0kouhj/STM32_ASC_ThirdRound_Car/设计总纲.docx

一、物料准备

4个TT130电机独立控制（2块TB6612 驱动）

- 对左右两侧测速（光电编码器×2）
- 红外反射模块×4
- 按键×4
- OLED屏幕×1（I2C）
- 主控：STM32F103C8T6（即“蓝色小板”）

二、引脚表

功能 | 引脚 | 备注
PWM M1 | PA0 (TIM2_CH1) | 左前电机
PWM M2 | PA1 (TIM2_CH2) | 右前电机
PWM M3 | PA2 (TIM2_CH3) | 左后电机
PWM M4 | PA3 (TIM2_CH4) | 右后电机
DIR1A, DIR1B | PB12, PB13 | TB6612 #1 左电机方向
DIR2A, DIR2B | PB14, PB15 | TB6612 #1 右电机方向
DIR3A, DIR3B | PC0, PC1 | TB6612 #2 左电机方向
DIR4A, DIR4B | PC2, PC3 | TB6612 #2 右电机方向
编码器左 | PA6 (TIM3_CH1) | 光电测速左
编码器右 | PA7 (TIM3_CH2) | 光电测速右
红外IR1~4 | PB0, PB1, PB10, PB11 | 寻迹模块输入
按键K1~4 | PA4, PA5, PC13, PC14 | 人机交互
OLED_SCL/SDA | PB6, PB7 | I2C接口

三、外设初始化分配

外设 | 用途 | 初始化建议
TIM2 | PWM输出（4通道） | 控制四电机
TIM3 | 输入捕获模式 | 测速用
GPIOB | 方向控制、红外输入、I2C
GPIOC | 方向控制、按键
GPIOA | PWM、按键、编码器信号
