0kouhj/STM32_ASC_ThirdRound_Car/智能车上板_2.SLDPRT

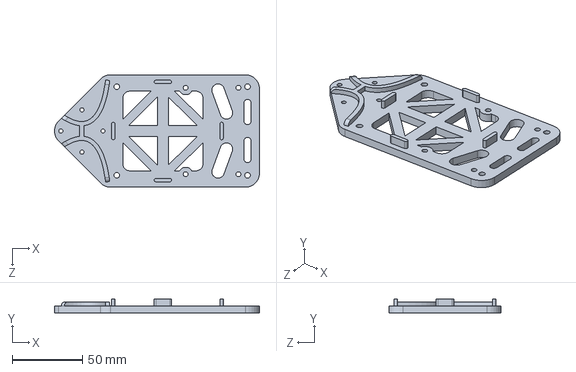
[picture p1: CAD file, 2025-11-28]
智能车上板_2.SLDPRT
145.8 x 10.0 x 80.0 mm
