0kouhj/STM32_ASC_ThirdRound_Car/智能车底板.SLDPRT

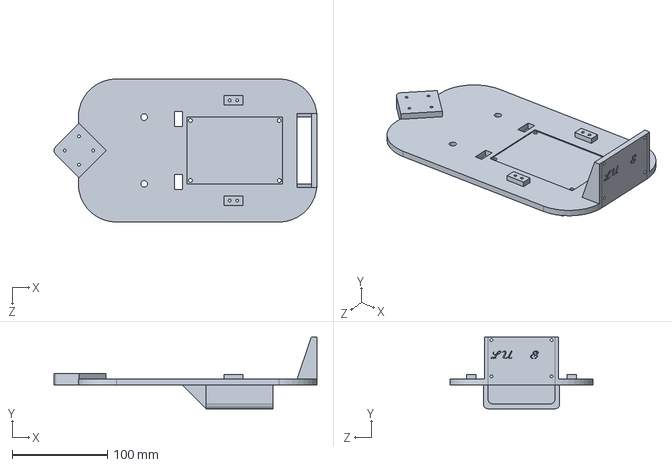
[picture p2: CAD file, 2025-11-28]
智能车底板.SLDPRT
275.5 x 75.0 x 150.0 mm
