0kouhj/STM32_ASC_ThirdRound_Car/智能车dipan_2.SLDPRT

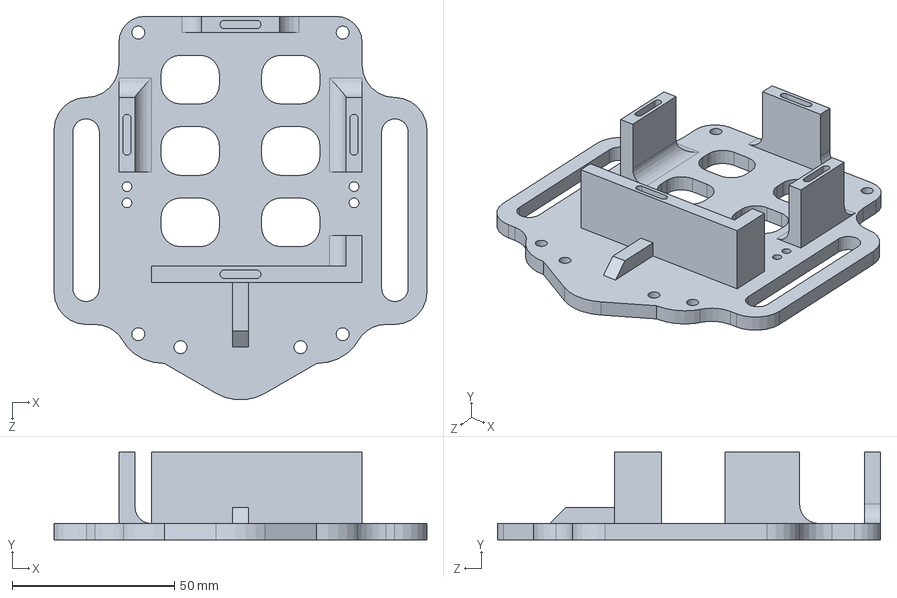
[picture p3: CAD file, 2025-11-28]
智能车dipan_2.SLDPRT
115.0 x 27.0 x 118.2 mm
