0kouhj/STM32_ASC_ThirdRound_Car/(list of files, cad)

Other CAD files:
智能车底板.STL
