0kouhj/STM32_ASC_ThirdRound_Car/Hardware/KEY.c

#include "stm32f10x.h"                  // Device header
#include "KEY.h"
#define KEY_PRESSED				1
#define KEY_UNPRESSED			0

#define KEY_TIME_DOUBLE			10
#define KEY_TIME_LONG			50
#define KEY_TIME_REPEAT			10
#define __KEY_H
#define KEY_COUNT				4

uint8_t Key_Flag[KEY_COUNT];

void KEY_Init(void)
{
	RCC_APB2PeriphClockCmd(RCC_APB2Periph_GPIOA, ENABLE);
	RCC_APB2PeriphClockCmd(RCC_APB2Periph_GPIOB, ENABLE);
	GPIO_InitTypeDef GPIO_InitStructure;
	GPIO_InitStructure.GPIO_Pin = GPIO_Pin_5|GPIO_Pin_4;
	GPIO_InitStructure.GPIO_Speed = GPIO_Speed_50MHz;
	GPIO_InitStructure.GPIO_Mode = GPIO_Mode_IPD;
	GPIO_Init(GPIOA,&GPIO_InitStructure);
	
	GPIO_InitStructure.GPIO_Mode = GPIO_Mode_IPU;
	GPIO_InitStructure.GPIO_Pin = GPIO_Pin_0|GPIO_Pin_1;
	GPIO_Init(GPIOB,&GPIO_InitStructure);
}

uint8_t Key_GetState(uint8_t n)
{
	if (n == KEY_1)
	{
		if (GPIO_ReadInputDataBit(GPIOA, GPIO_Pin_4) == 1)
		{
			return KEY_PRESSED;
		}
	}
	else if (n == KEY_2)
	{
		if (GPIO_ReadInputDataBit(GPIOA, GPIO_Pin_5) == 1)
		{
			return KEY_PRESSED;
		}
	}
	else if (n == KEY_3)
	{
		if (GPIO_ReadInputDataBit(GPIOB, GPIO_Pin_1) == 0)
		{
			return KEY_PRESSED;
		}
	}
	else if (n == KEY_4)
	{
		if (GPIO_ReadInputDataBit(GPIOB, GPIO_Pin_1) == 0)
		{
			return KEY_PRESSED;
		}
	}
	return KEY_UNPRESSED;
}
uint8_t Key_Check(uint8_t n, uint8_t Flag)
{
	if (Key_Flag[n] & Flag)
	{
		if (Flag != KEY_HOLD)
		{
			Key_Flag[n] &= ~Flag;
		}
		return 1;
	}
	return 0;
}

void Key_Tick(void)
{
	static uint8_t Count, i;
	static uint8_t CurrState[KEY_COUNT], PrevState[KEY_COUNT];
	static uint8_t S[KEY_COUNT];
	static uint16_t Time[KEY_COUNT];
	
	for (i = 0; i < KEY_COUNT; i ++)
	{
		if (Time[i] > 0)
		{
			Time[i] --;
		}
	}
	
	Count ++;
	if (Count >= 5)
	{
		Count = 0;
		
		for (i = 0; i < KEY_COUNT; i ++)
		{
			PrevState[i] = CurrState[i];
			CurrState[i] = Key_GetState(i);
			
			if (CurrState[i] == KEY_PRESSED)
			{
				Key_Flag[i] |= KEY_HOLD;
			}
			else
			{
				Key_Flag[i] &= ~KEY_HOLD;
			}
			
			if (CurrState[i] == KEY_PRESSED && PrevState[i] == KEY_UNPRESSED)
			{
				Key_Flag[i] |= KEY_DOWN;
			}
			
			if (CurrState[i] == KEY_UNPRESSED && PrevState[i] == KEY_PRESSED)
			{
				Key_Flag[i] |= KEY_UP;
			}
			
			if (S[i] == 0)
			{
				if (CurrState[i] == KEY_PRESSED)
				{
					Time[i] = KEY_TIME_LONG;
					S[i] = 1;
				}
			}
			else if (S[i] == 1)
			{
				if (CurrState[i] == KEY_UNPRESSED)
				{
					Time[i] = KEY_TIME_DOUBLE;
					S[i] = 2;
				}
				else if (Time[i] == 0)
				{
					Time[i] = KEY_TIME_REPEAT;
					Key_Flag[i] |= KEY_LONG;
					S[i] = 4;
				}
			}
			else if (S[i] == 2)
			{
				if (CurrState[i] == KEY_PRESSED)
				{
					Key_Flag[i] |= KEY_DOUBLE;
					S[i] = 3;
				}
				else if (Time[i] == 0)
				{
					Key_Flag[i] |= KEY_SINGLE;
					S[i] = 0;
				}
			}
			else if (S[i] == 3)
			{
				if (CurrState[i] == KEY_UNPRESSED)
				{
					S[i] = 0;
				}
			}
			else if (S[i] == 4)
			{
				if (CurrState[i] == KEY_UNPRESSED)
				{
					S[i] = 0;
				}
				else if (Time[i] == 0)
				{
					Time[i] = KEY_TIME_REPEAT;
					Key_Flag[i] |= KEY_REPEAT;
					S[i] = 4;
				}
			}
		}
	}
}
