0kouhj/STM32_ASC_ThirdRound_Car/Software/Serial.c

#include "stm32f10x.h"
#include "serial.h"
#include "communication.h"
#include <stdio.h>
#include <stdarg.h>

// 简化接收变量
volatile uint8_t usart_rx_buffer[100];
volatile uint8_t usart_rx_index = 0;
volatile uint8_t usart_rx_ready = 0;

// 为了兼容性，保留外部变量声明但设置为0
char Serial_RxPacket[100] = {0};
uint8_t Serial_RxFlag = 0;

void Serial_Init(void)
{
    GPIO_InitTypeDef GPIO_InitStructure;
    USART_InitTypeDef USART_InitStructure;
    NVIC_InitTypeDef NVIC_InitStructure;
    
    /* 开启时钟 */
    RCC_APB1PeriphClockCmd(RCC_APB1Periph_USART2, ENABLE);
    RCC_APB2PeriphClockCmd(RCC_APB2Periph_GPIOA | RCC_APB2Periph_AFIO, ENABLE);
    
    /* 配置TX引脚(PA2) */
    GPIO_InitStructure.GPIO_Pin = GPIO_Pin_2;
    GPIO_InitStructure.GPIO_Mode = GPIO_Mode_AF_PP;
    GPIO_InitStructure.GPIO_Speed = GPIO_Speed_50MHz;
    GPIO_Init(GPIOA, &GPIO_InitStructure);
    
    /* 配置RX引脚(PA3) */
    GPIO_InitStructure.GPIO_Pin = GPIO_Pin_3;
    GPIO_InitStructure.GPIO_Mode = GPIO_Mode_IN_FLOATING;
    GPIO_InitStructure.GPIO_Speed = GPIO_Speed_50MHz;
    GPIO_Init(GPIOA, &GPIO_InitStructure);
    
    /* USART2配置 */
    USART_InitStructure.USART_BaudRate = 9600;
    USART_InitStructure.USART_WordLength = USART_WordLength_8b;
    USART_InitStructure.USART_StopBits = USART_StopBits_1;
    USART_InitStructure.USART_Parity = USART_Parity_No;
    USART_InitStructure.USART_HardwareFlowControl = USART_HardwareFlowControl_None;
    USART_InitStructure.USART_Mode = USART_Mode_Tx | USART_Mode_Rx;
    USART_Init(USART2, &USART_InitStructure);
    
    /* 使能接收中断 */
    USART_ITConfig(USART2, USART_IT_RXNE, ENABLE);
    
    /* 配置NVIC */
    NVIC_PriorityGroupConfig(NVIC_PriorityGroup_2);
    NVIC_InitStructure.NVIC_IRQChannel = USART2_IRQn;
    NVIC_InitStructure.NVIC_IRQChannelCmd = ENABLE;
    NVIC_InitStructure.NVIC_IRQChannelPreemptionPriority = 1;
    NVIC_InitStructure.NVIC_IRQChannelSubPriority = 1;
    NVIC_Init(&NVIC_InitStructure);
    
    /* 使能USART2 */
    USART_Cmd(USART2, ENABLE);
}

void Serial_SendByte(uint8_t Byte)
{
    USART_SendData(USART2, Byte);
    while (USART_GetFlagStatus(USART2, USART_FLAG_TXE) == RESET);
}

void Serial_SendArray(uint8_t *Array, uint16_t Length)
{
    uint16_t i;
    for (i = 0; i < Length; i++)
    {
        Serial_SendByte(Array[i]);
    }
}

void Serial_SendString(char *String)
{
    uint8_t i;
    for (i = 0; String[i] != '\0'; i++)
    {
        Serial_SendByte(String[i]);
    }
}

uint32_t Serial_Pow(uint32_t X, uint32_t Y)
{
    uint32_t Result = 1;
    while (Y--)
    {
        Result *= X;
    }
    return Result;
}

void Serial_SendNumber(uint32_t Number, uint8_t Length)
{
    uint8_t i;
    for (i = 0; i < Length; i++)
    {
        Serial_SendByte(Number / Serial_Pow(10, Length - i - 1) % 10 + '0');
    }
}

int fputc(int ch, FILE *f)
{
    Serial_SendByte(ch);
    return ch;
}

void Serial_Printf(char *format, ...)
{
    char String[100];
    va_list arg;
    va_start(arg, format);
    vsprintf(String, format, arg);
    va_end(arg);
    Serial_SendString(String);
}

void USART2_IRQHandler(void)
{
    if (USART_GetITStatus(USART2, USART_IT_RXNE) != RESET) {
        uint8_t data = USART_ReceiveData(USART2);
        Serial_Command_RxHandler(data);
        USART_ClearITPendingBit(USART2, USART_IT_RXNE);
    }
}
