0kouhj/STM32_ASC_ThirdRound_Car/(commit log)

2025-11-06 添加了二轮的代码,以及小车的设计和引脚分配
2025-11-09 编写了PID算法,完善了引脚分配,做好了串口通讯
2025-11-10 实现了双链表OLED菜单管理,编写了DEBUG参数显示页面,紧急停止页面,Test页面,完善了紧急停止功能
2025-11-28 Latest Ver
    [智能车dipan_2.SLDPRT, 智能车上板_2.SLDPRT, 智能车底板.SLDPRT, 智能车底板.STL]
